aryanthomare/SmartKnob/docs/images/haptic_profile_dark.png

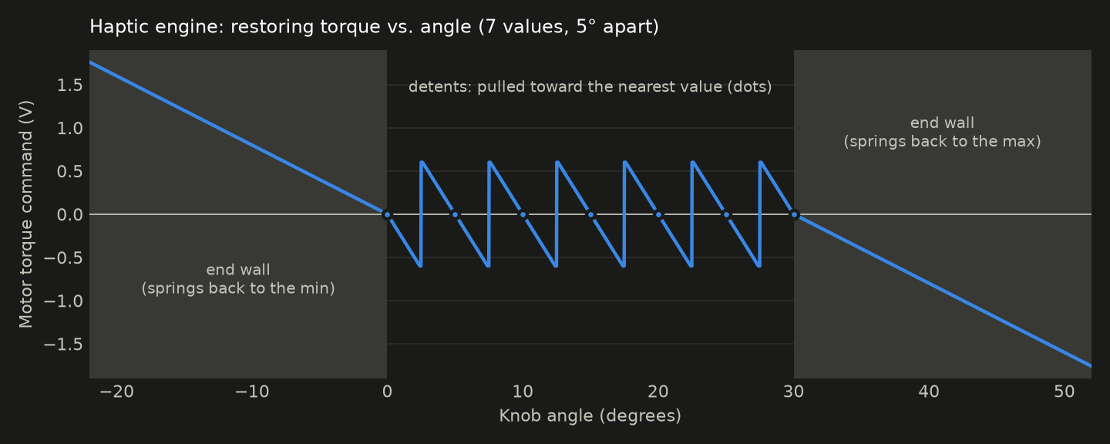
docs/images/haptic_profile_dark.png
