aryanthomare/SmartKnob/docs/images/panel_scroll_dark.png

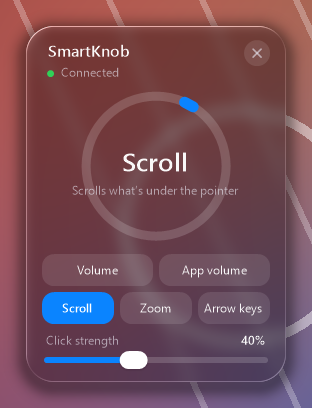
docs/images/panel_scroll_dark.png
