aryanthomare/SmartKnob/docs/images/panel_volume_light.png

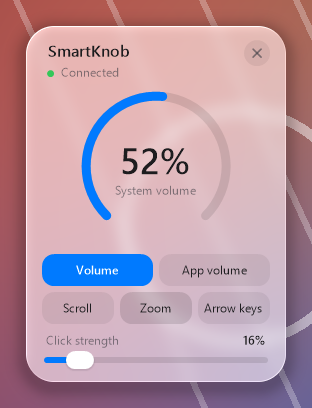
docs/images/panel_volume_light.png
