aryanthomare/SmartKnob/docs/images/schematic_overview.png

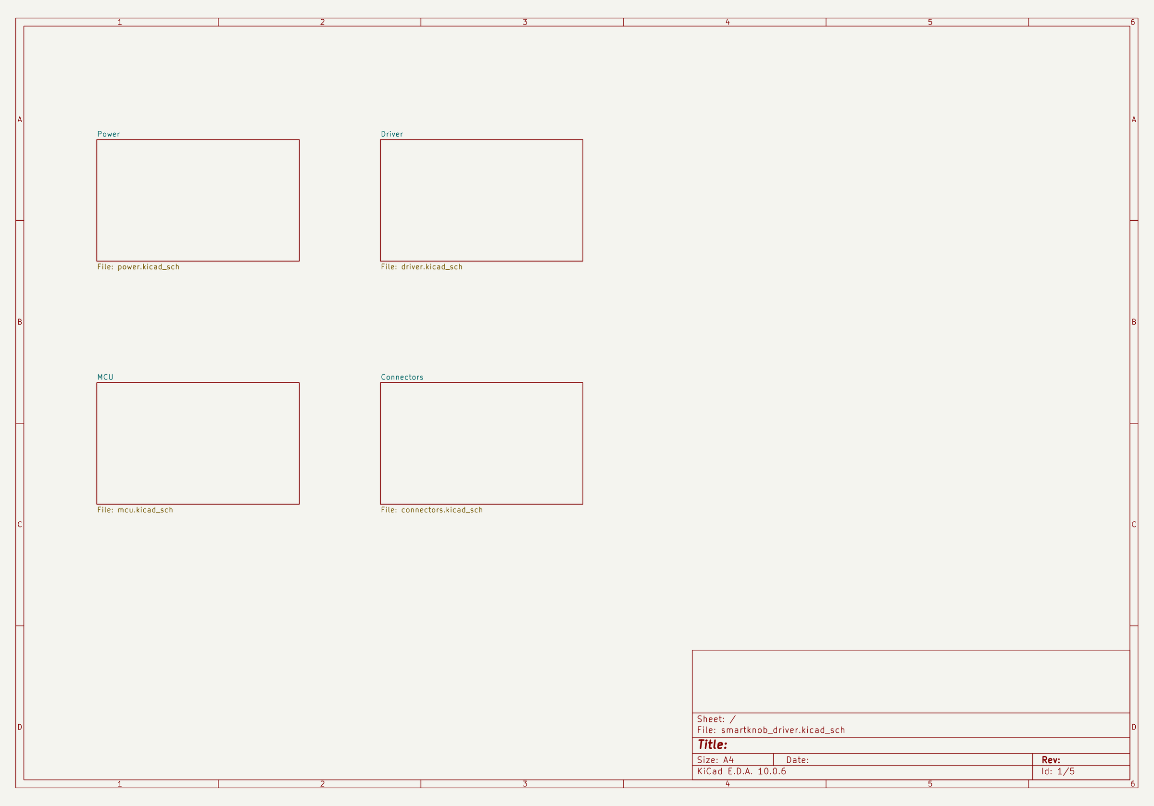
docs/images/schematic_overview.png
