aryanthomare/SmartKnob/hardware/smartknob_driver/smartknob_driver_placement_2d.png

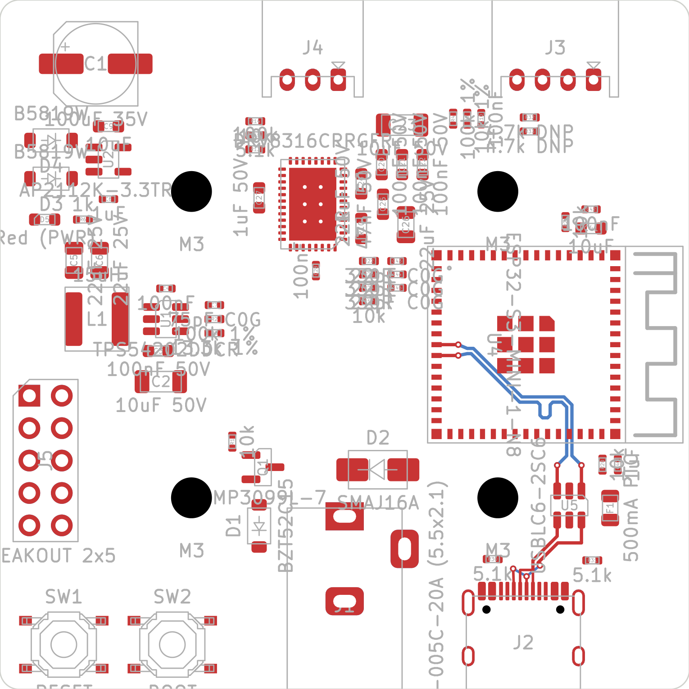
hardware/smartknob_driver/smartknob_driver_placement_2d.png
