aryanthomare/SmartKnob/hardware/smartknob_driver/smartknob_driver_placement_3d.png

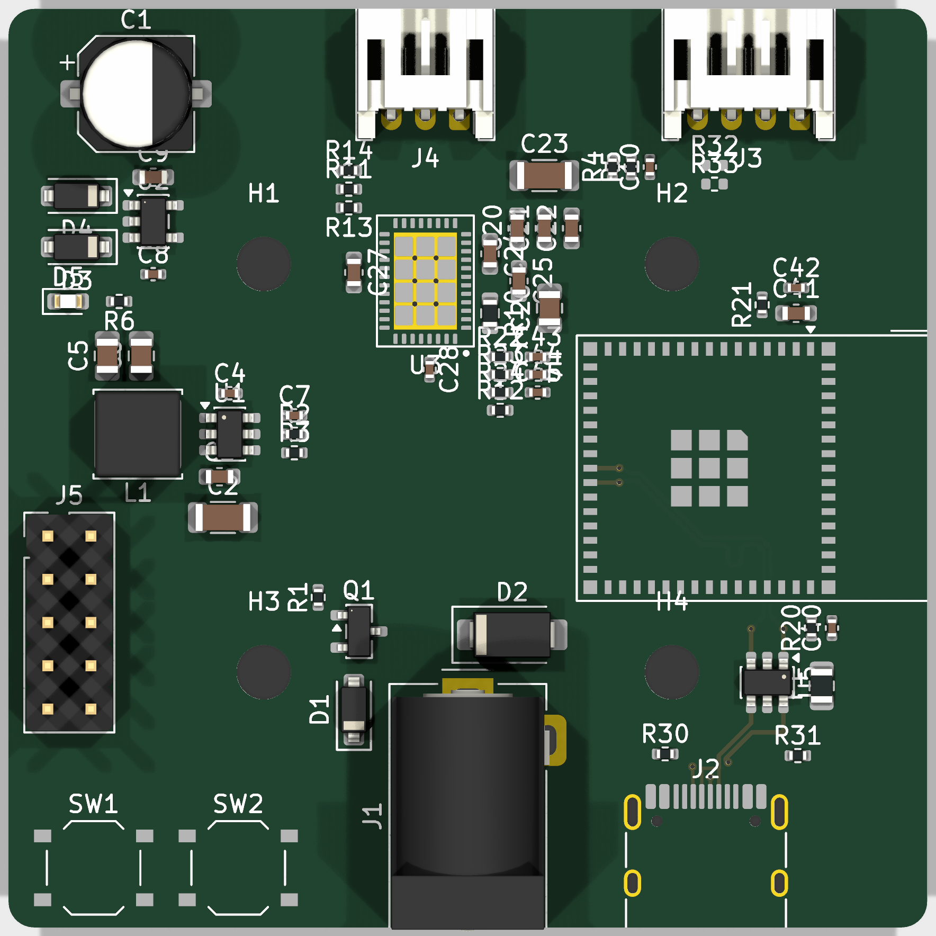
hardware/smartknob_driver/smartknob_driver_placement_3d.png
