aryanthomare/SmartKnob/hardware/smartknob_driver/smartknob_driver_top_render.png

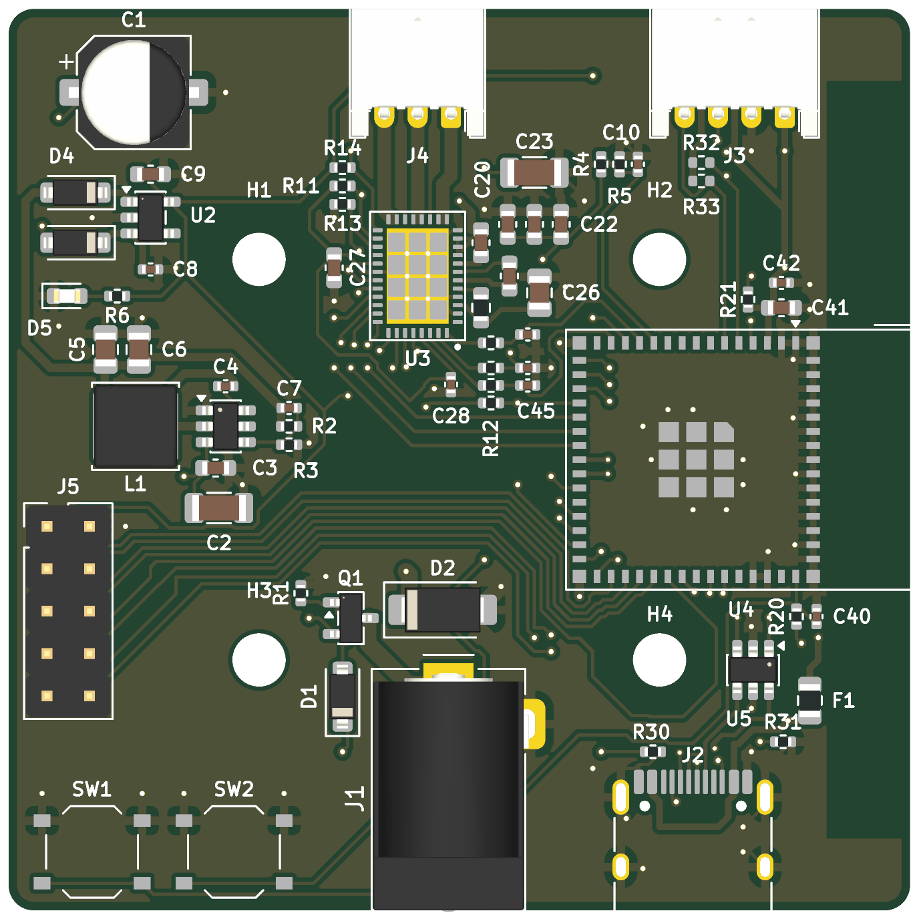
hardware/smartknob_driver/smartknob_driver_top_render.png
