aryanthomare/SmartKnob/hardware/smartknob_driver/fab/smartknob_driver_BOM_JLC.csv

Comment | Designator | Footprint | LCSC Part # | Quantity
100uF 35V | C1 | Capacitor_SMD:CP_Elec_6.3x7.7 | C294520 | 1
10uF 50V | C2,C23 | Capacitor_SMD:C_1206_3216Metric | C13585 | 2
100nF 50V | C3,C20,C21,C22 | Capacitor_SMD:C_0603_1608Metric | C14663 | 4
100nF | C4,C10,C28,C42 | Capacitor_SMD:C_0402_1005Metric | C1525 | 4
22uF 25V | C5,C6,C26 | Capacitor_SMD:C_0805_2012Metric | C45783 | 3
75pF C0G | C7 | Capacitor_SMD:C_0402_1005Metric | C107010 | 1
1uF | C8,C40 | Capacitor_SMD:C_0402_1005Metric | C52923 | 2
10uF | C9,C41 | Capacitor_SMD:C_0603_1608Metric | C19702 | 2
1uF 50V | C24,C27 | Capacitor_SMD:C_0603_1608Metric | C15849 | 2
47nF 50V | C25 | Capacitor_SMD:C_0603_1608Metric | C1622 | 1
22pF C0G | C43,C44,C45 | Capacitor_SMD:C_0402_1005Metric | C1555 | 3
BZT52C15 | D1 | Diode_SMD:D_SOD-123 | C2932746 | 1
SMAJ16A | D2 | Diode_SMD:D_SMA | C74561 | 1
B5819W | D3,D4 | Diode_SMD:D_SOD-123 | C8598 | 2
Red (PWR) | D5 | LED_SMD:LED_0603_1608Metric | C2286 | 1
500mA PTC | F1 | Fuse:Fuse_0805_2012Metric | C20978 | 1
DC-005C-20A (5.5x2.1) | J1 | smartknob:BarrelJack_Hroparts_DC-005C-20A_Horizontal | C84007 | 1
TYPE-C-31-M-12 | J2 | Connector_USB:USB_C_Receptacle_HRO_TYPE-C-31-M-12 | C165948 | 1
ENCODER (S4B-PH-K-S) | J3 | Connector_JST:JST_PH_S4B-PH-K_1x04_P2.00mm_Horizontal | C157926 | 1
MOTOR (S3B-PH-K-S) | J4 | Connector_JST:JST_PH_S3B-PH-K_1x03_P2.00mm_Horizontal | C157929 | 1
BREAKOUT 2x5 | J5 | Connector_PinHeader_2.54mm:PinHeader_2x05_P2.54mm_Vertical |  | 1
15uH | L1 | Inductor_SMD:L_Sunlord_SWPA5040S | C44888 | 1
DMP3099L-7 | Q1 | Package_TO_SOT_SMD:SOT-23 | C155244 | 1
10k 1% | R1,R5,R12,R14,R20,R21 | Resistor_SMD:R_0402_1005Metric | C25744 | 6
100k 1% | R2,R4,R13 | Resistor_SMD:R_0402_1005Metric | C25741 | 3
13.3k 1% | R3 | Resistor_SMD:R_0402_1005Metric | C274352 | 1
1k | R6 | Resistor_SMD:R_0402_1005Metric | C11702 | 1
22R | R10 | Resistor_SMD:R_0603_1608Metric | C23345 | 1
5.1k | R11,R30,R31 | Resistor_SMD:R_0402_1005Metric | C25905 | 3
330R | R22,R23,R24 | Resistor_SMD:R_0402_1005Metric | C25104 | 3
TS-1187A pushbutton | SW1,SW2 | Button_Switch_SMD:SW_Push_1P1T_XKB_TS-1187A | C318884 | 2
TPS54202DDCR | U1 | Package_TO_SOT_SMD:SOT-23-6 | C191884 | 1
AP2112K-3.3TRG1 | U2 | Package_TO_SOT_SMD:SOT-23-5 | C51118 | 1
DRV8316CRRGFR | U3 | smartknob:TI_RGF0040E_VQFN-40-1EP_5x7mm_P0.5mm_EP3.7x5.7mm_ThermalVias | C5447274 | 1
ESP32-S3-MINI-1-N8 | U4 | RF_Module:ESP32-S2-MINI-1 | C2913206 | 1
USBLC6-2SC6 | U5 | Package_TO_SOT_SMD:SOT-23-6 | C7519 | 1
