aryanthomare/SmartKnob/enclosure/smartknob_driver.step

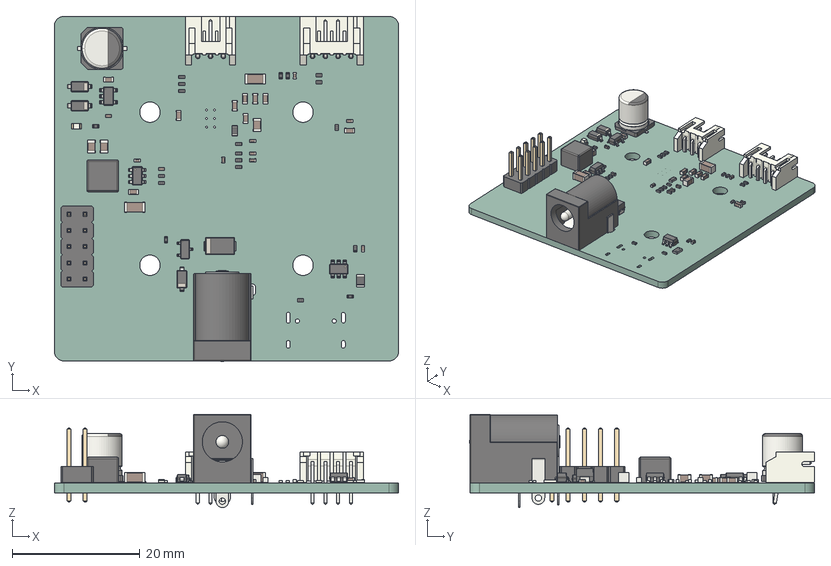
[picture p21: CAD file, 2026-10-10]
enclosure/smartknob_driver.step
54.0 x 54.1 x 14.6 mm
C_0402_1005Metric x 10
R_0402_1005Metric x 19
PinHeader_2x05_P254mm_Vertical
C_0603_1608Metric x 9
JST_S4B_PH_K
D_SOD-123 x 3
C_1206_3216Metric x 2
Fuse_0805_2012Metric
SOT-23-6 x 2
BarrelJack_Horizontal
SOT-23
JST_S3B_PH_K
C_0805_2012Metric x 3
LED_0603_1608Metric
SOT-23-5
R_0603_1608Metric
a69dfe88-8551-11ed-a139-00155d22e2d7_part
a69dffdc-8551-11ed-a139-00155d22e2d7_part
a69e005e-8551-11ed-a139-00155d22e2d7_part
CP_Elec_63x77
D_SMA
smartknob_driver_PCB
