aryanthomare/SmartKnob/hardware/smartknob_driver/smartknob_driver_schematic.pdf

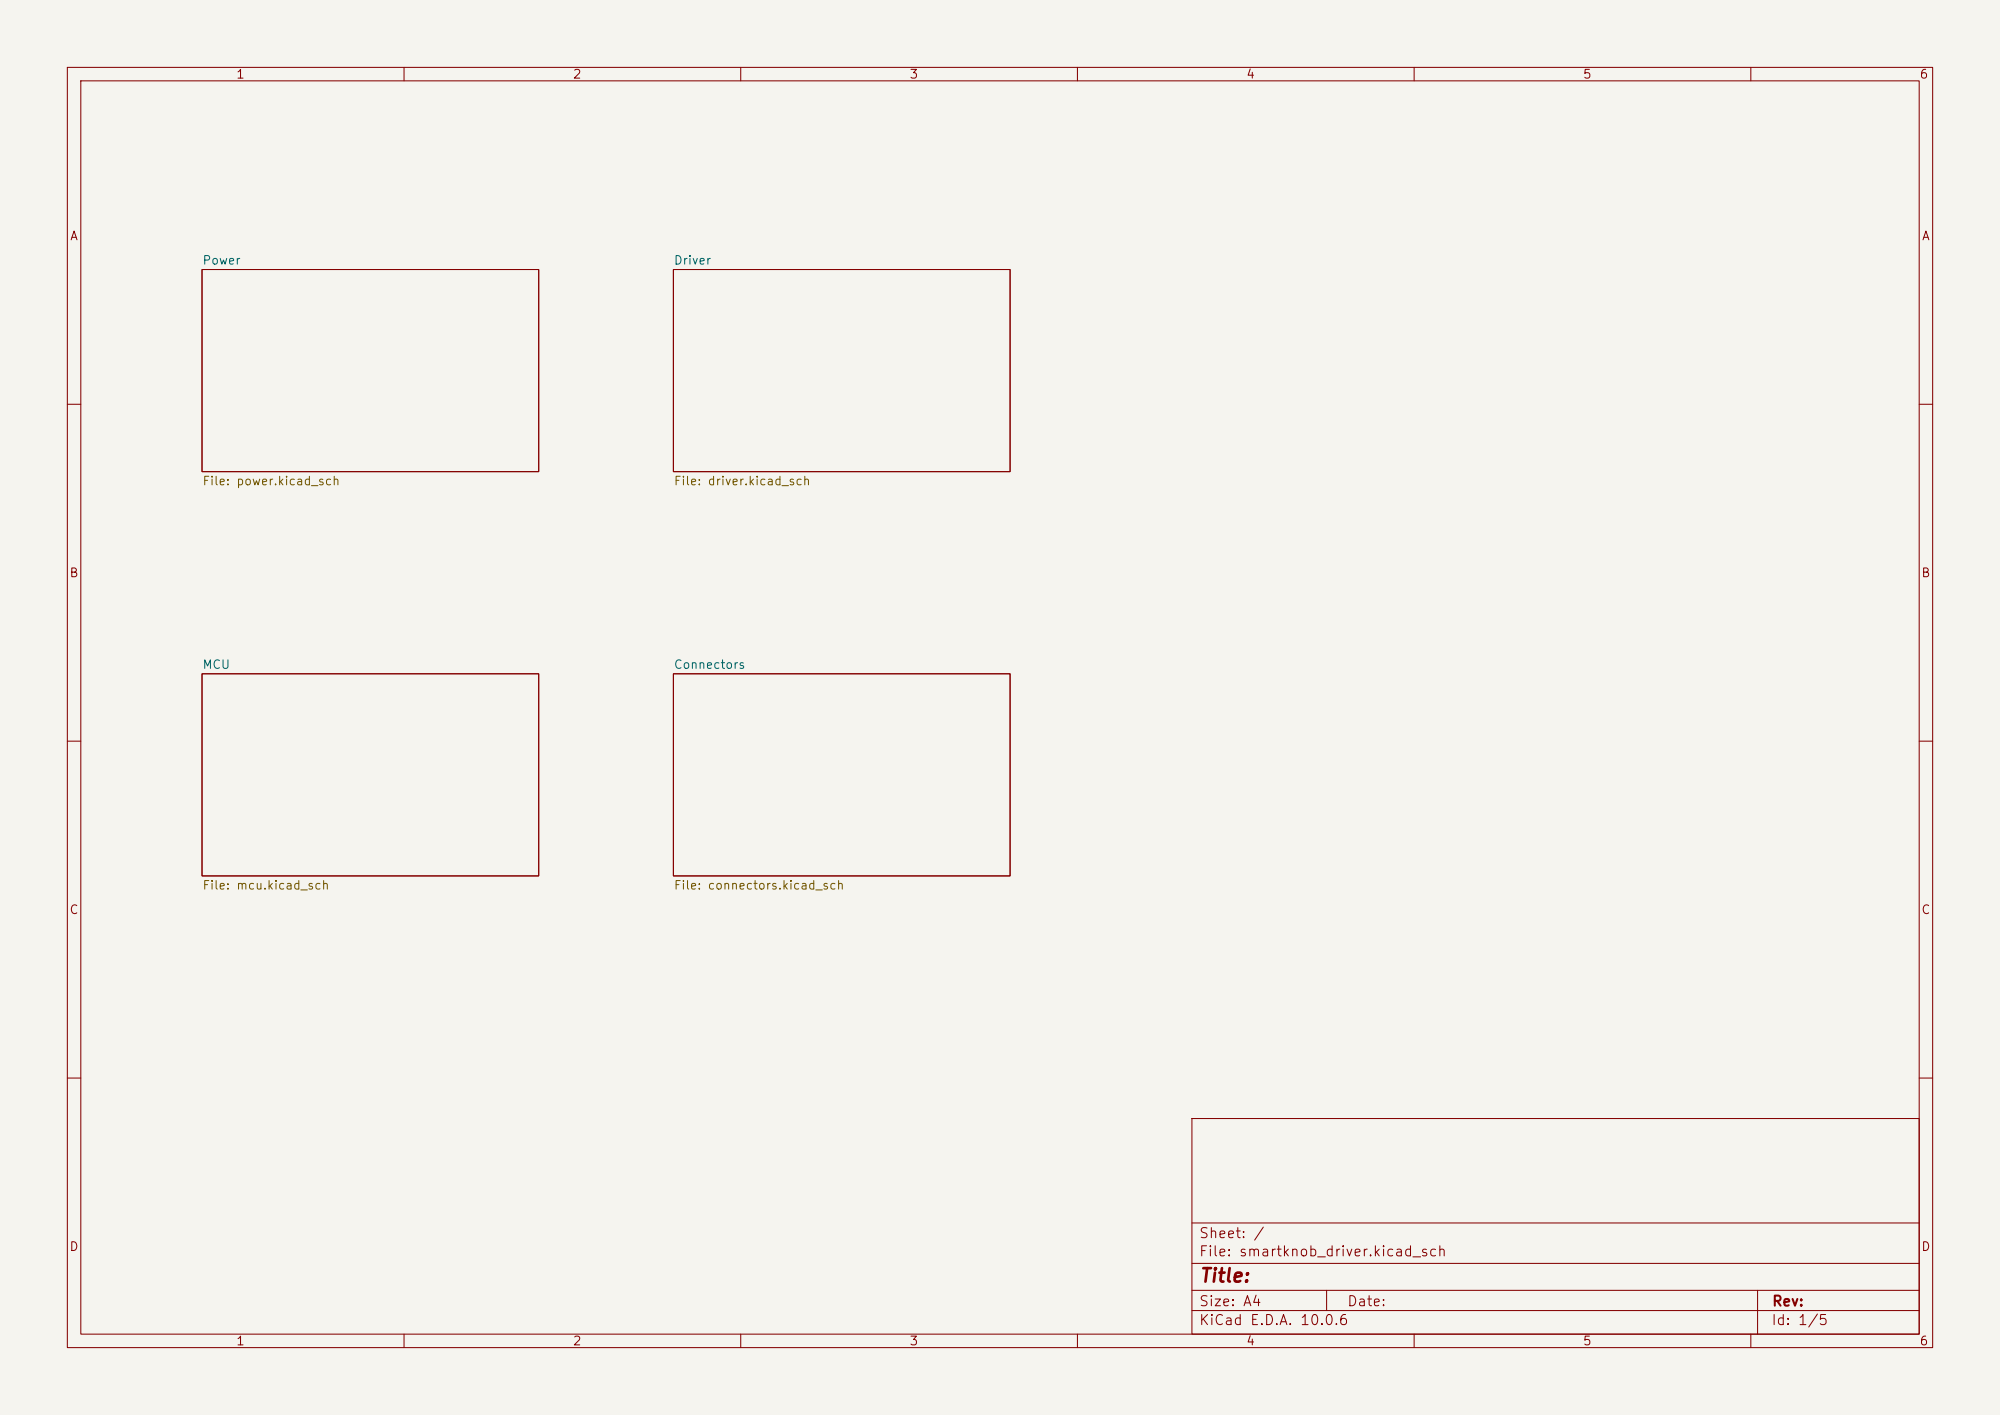
[picture p22: page 1]

Size: A4 | Rev:
KiCad E.D.A. 10.0.6 | Id: 1/5

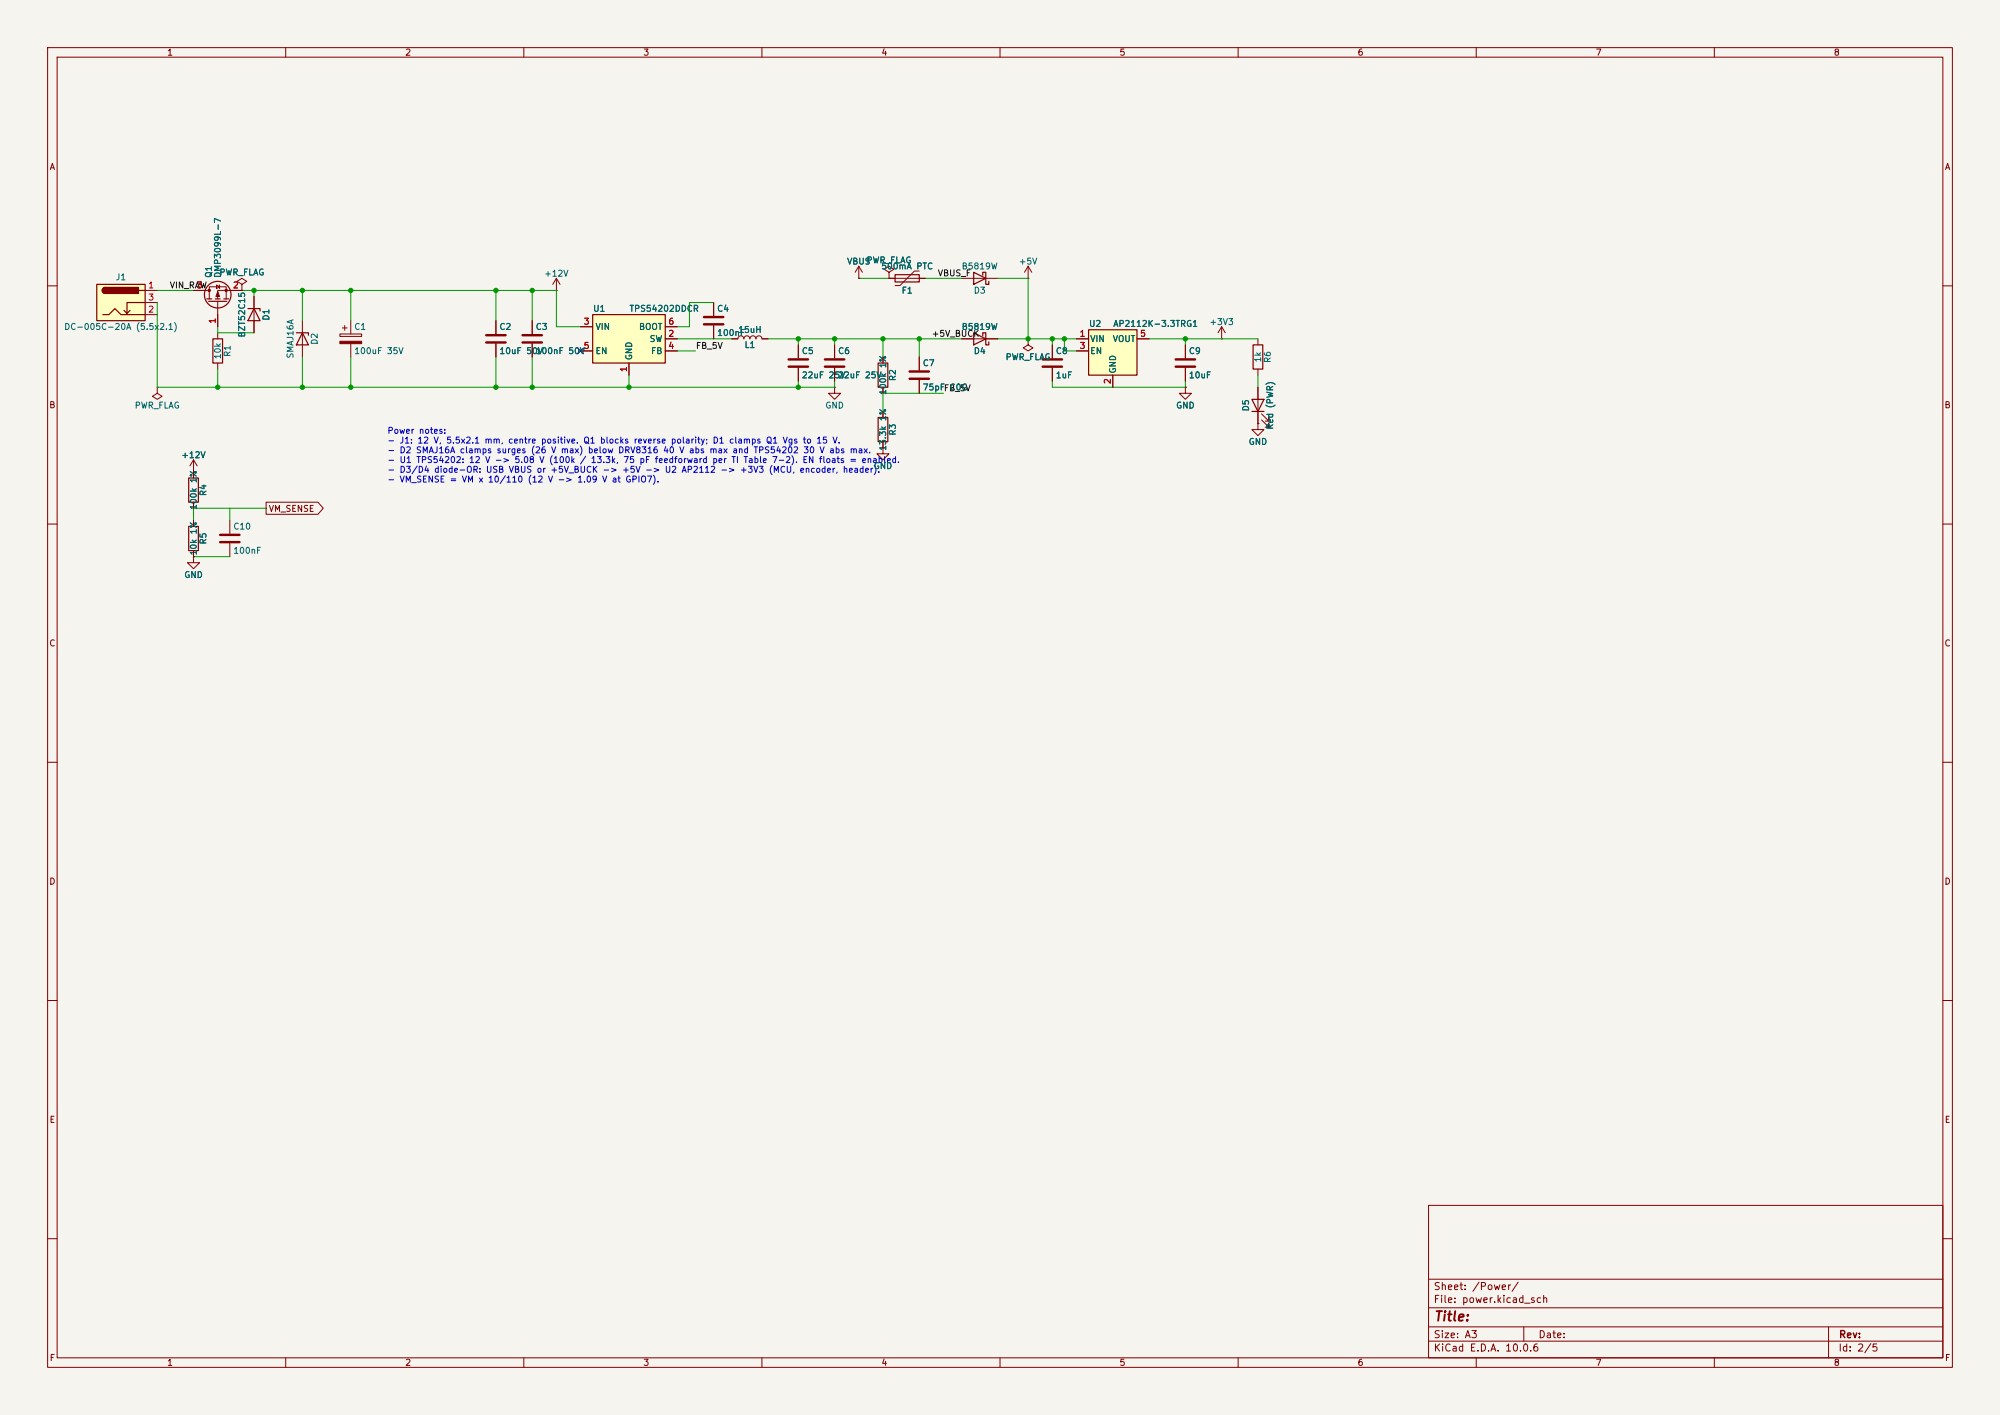
[picture p23: page 2]

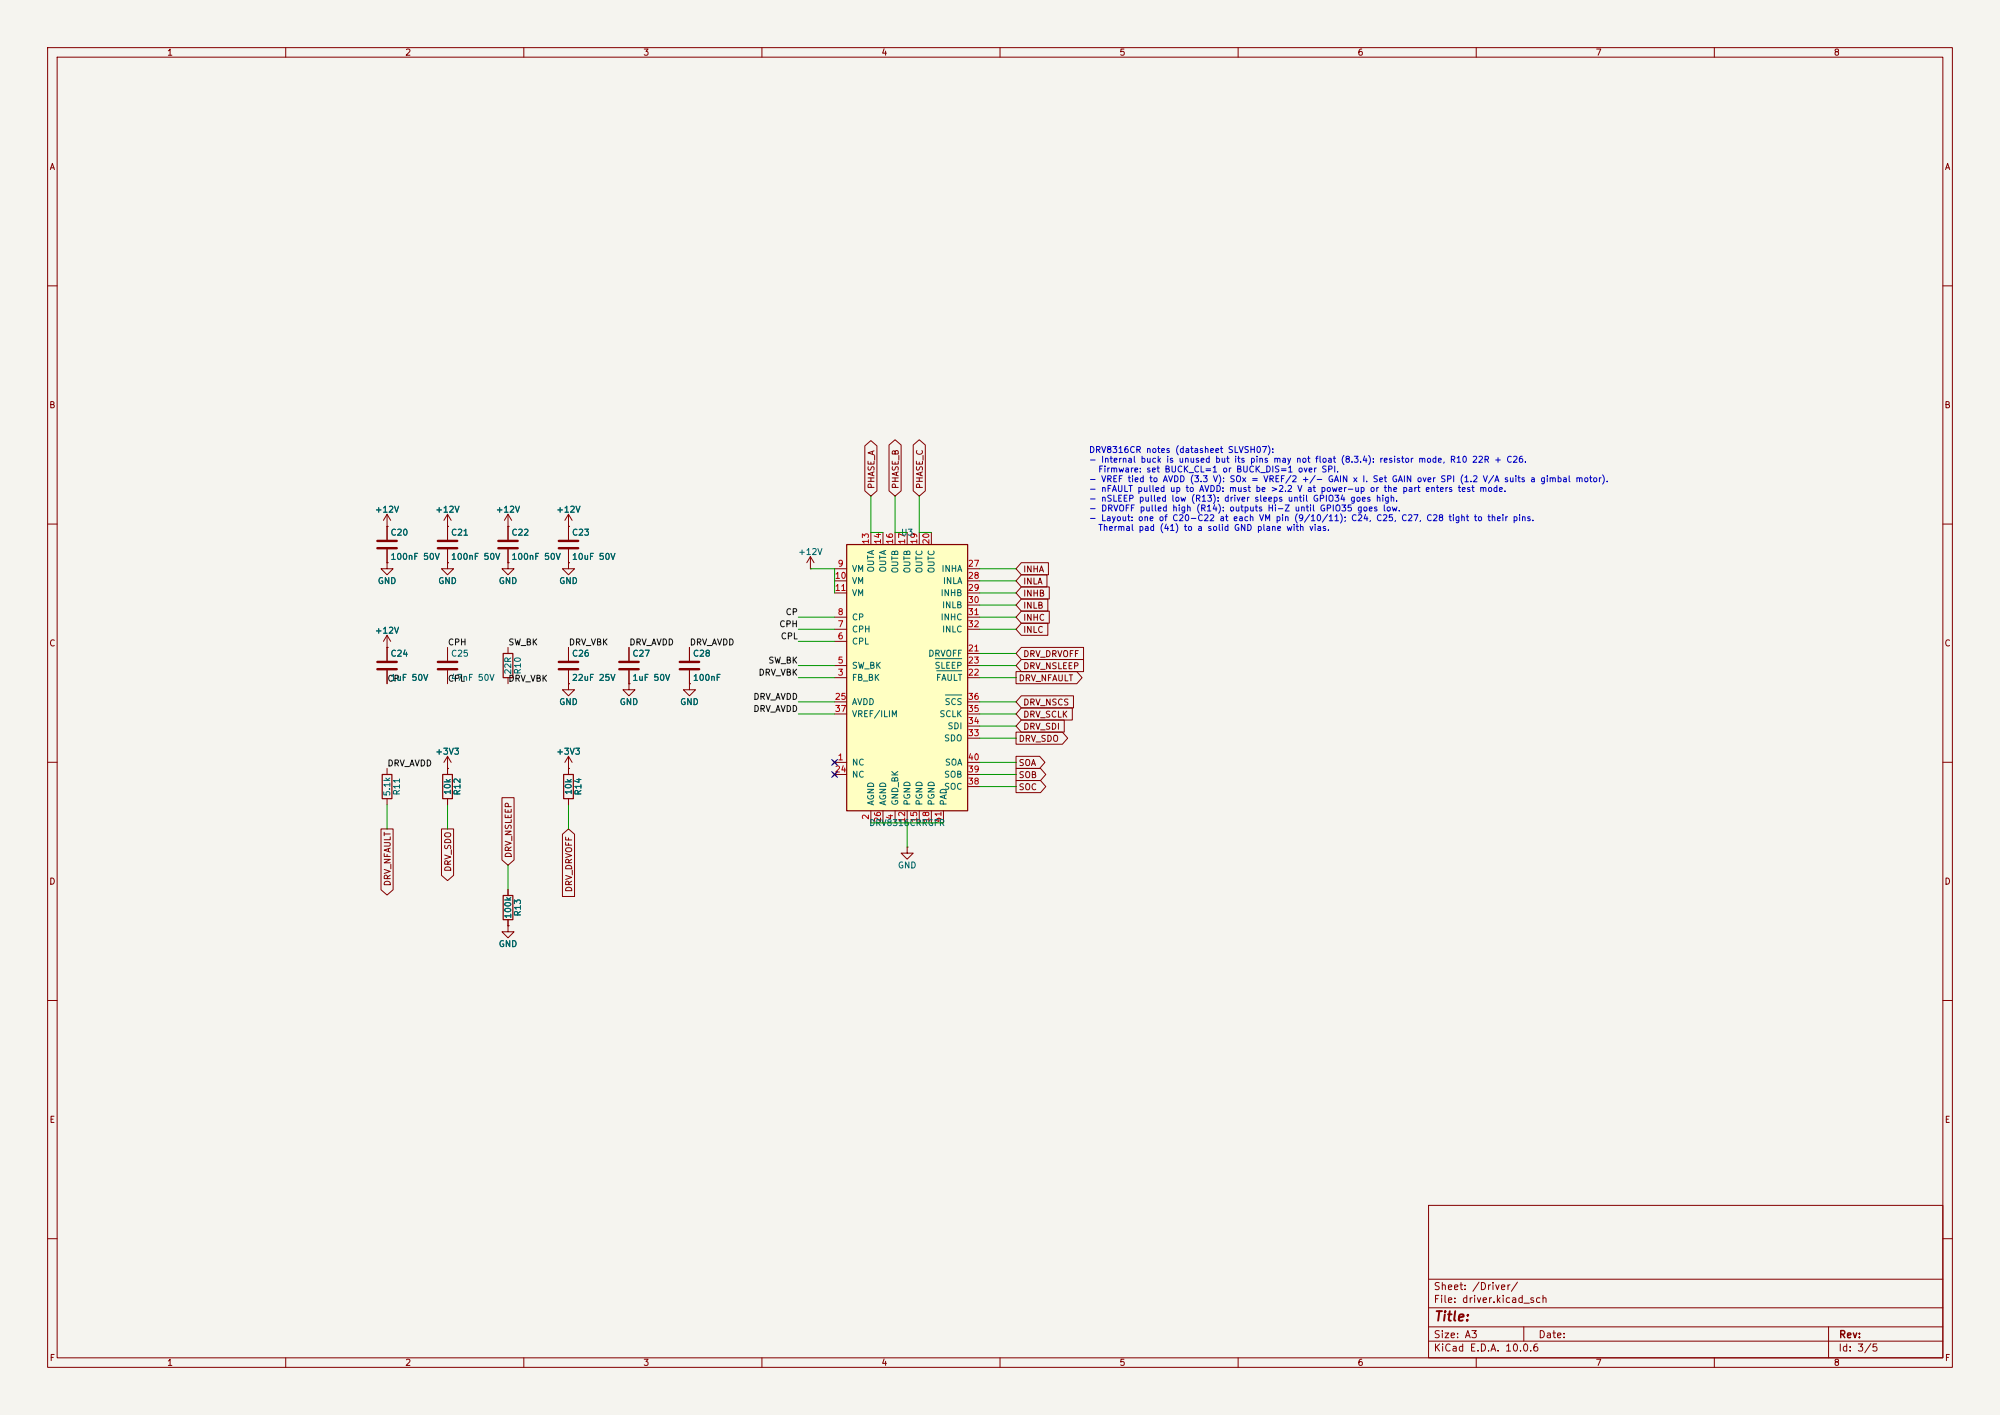
[picture p24: page 3]

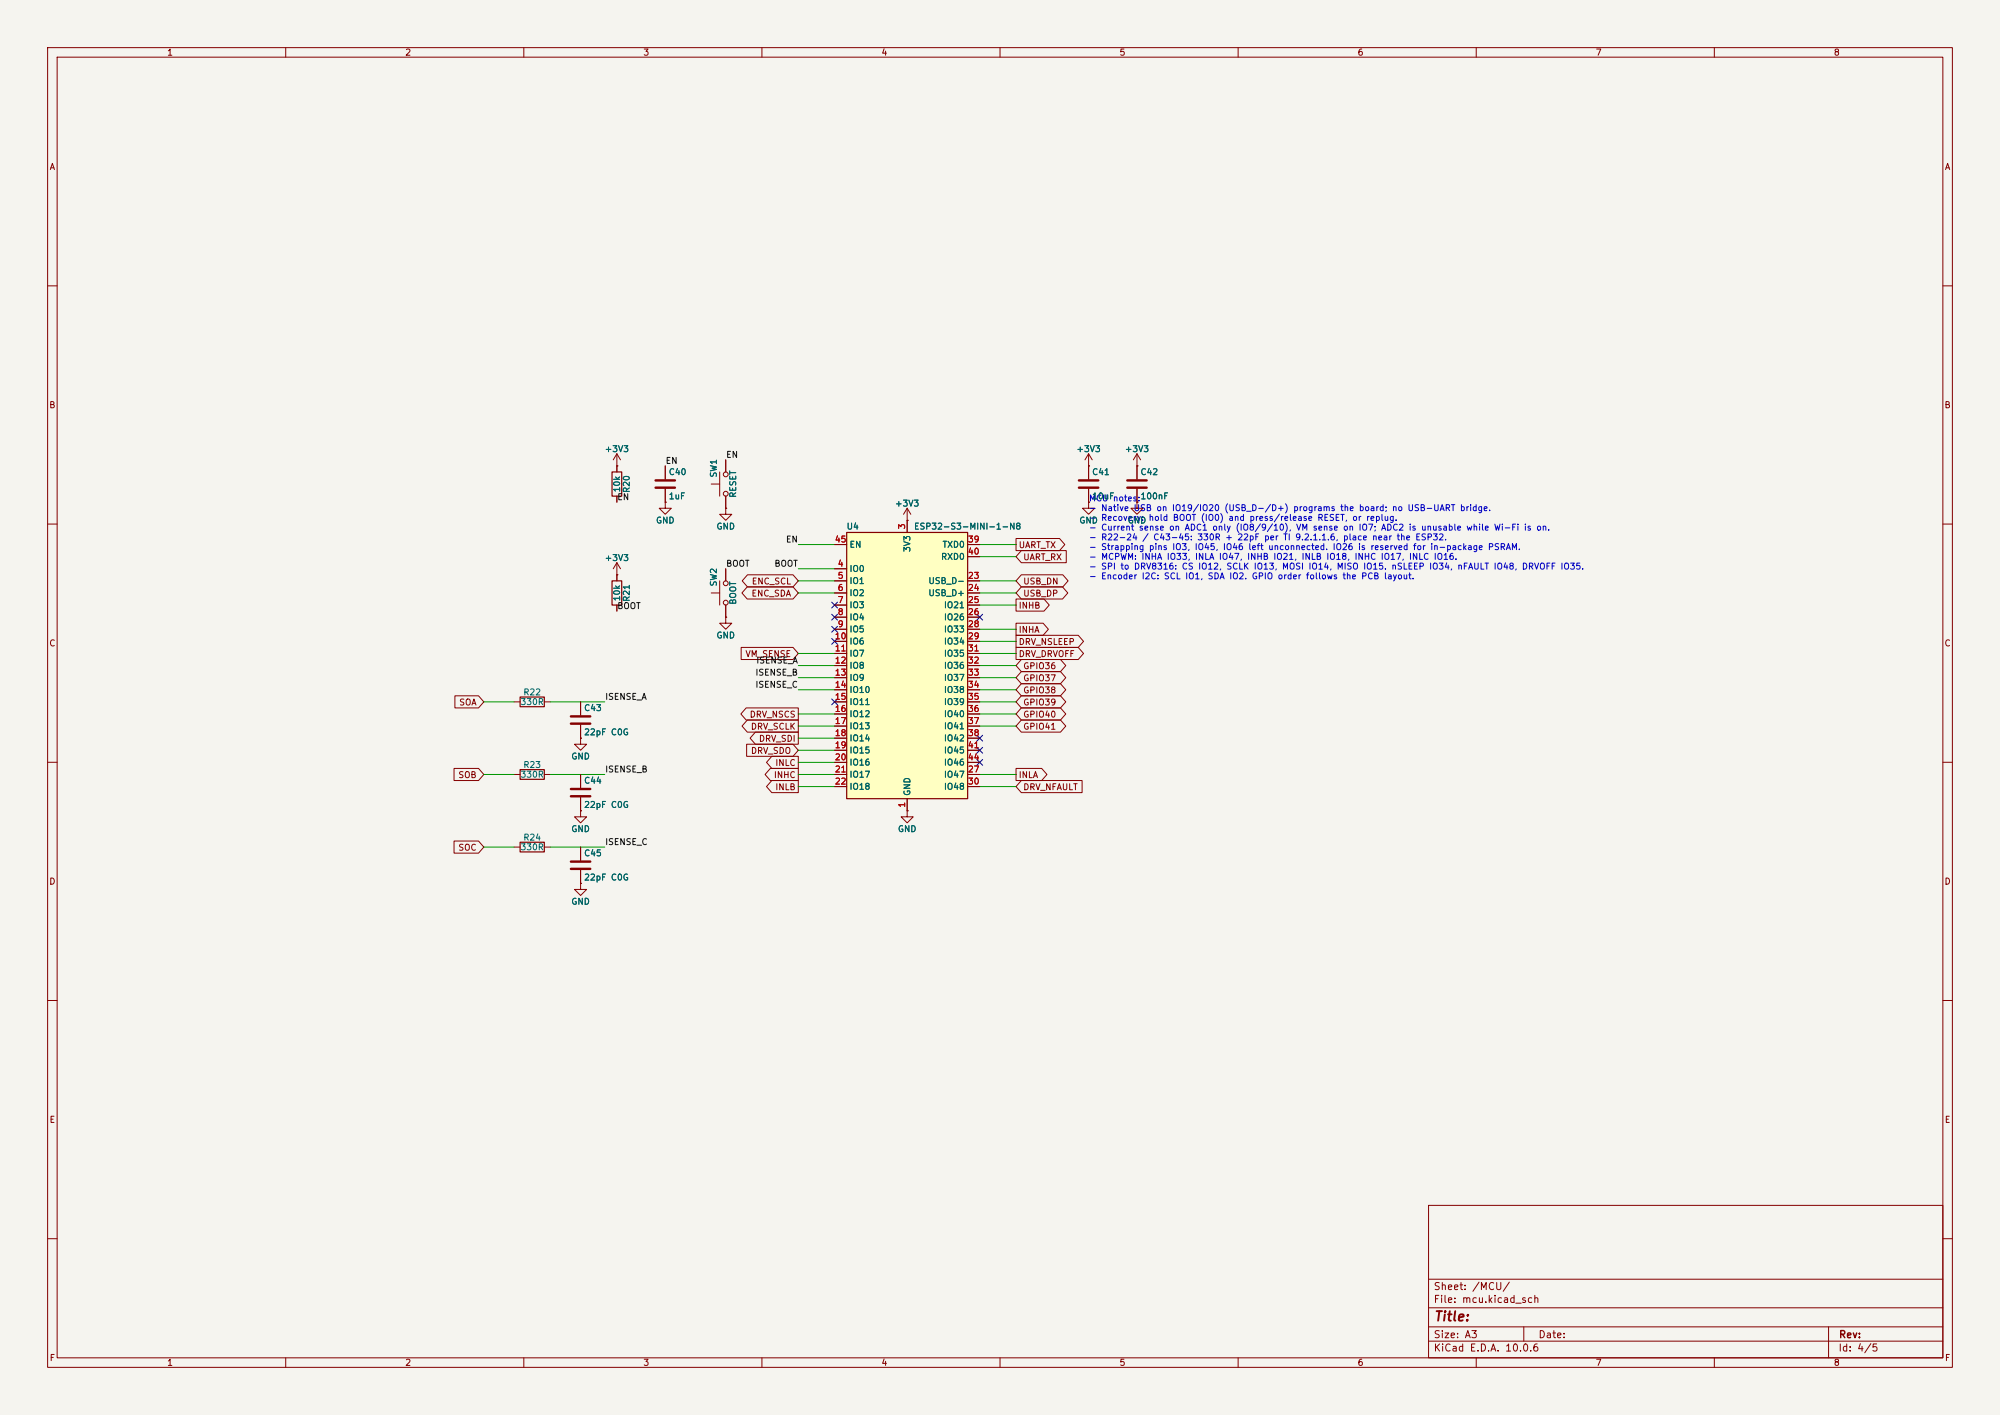
[picture p25: page 4]

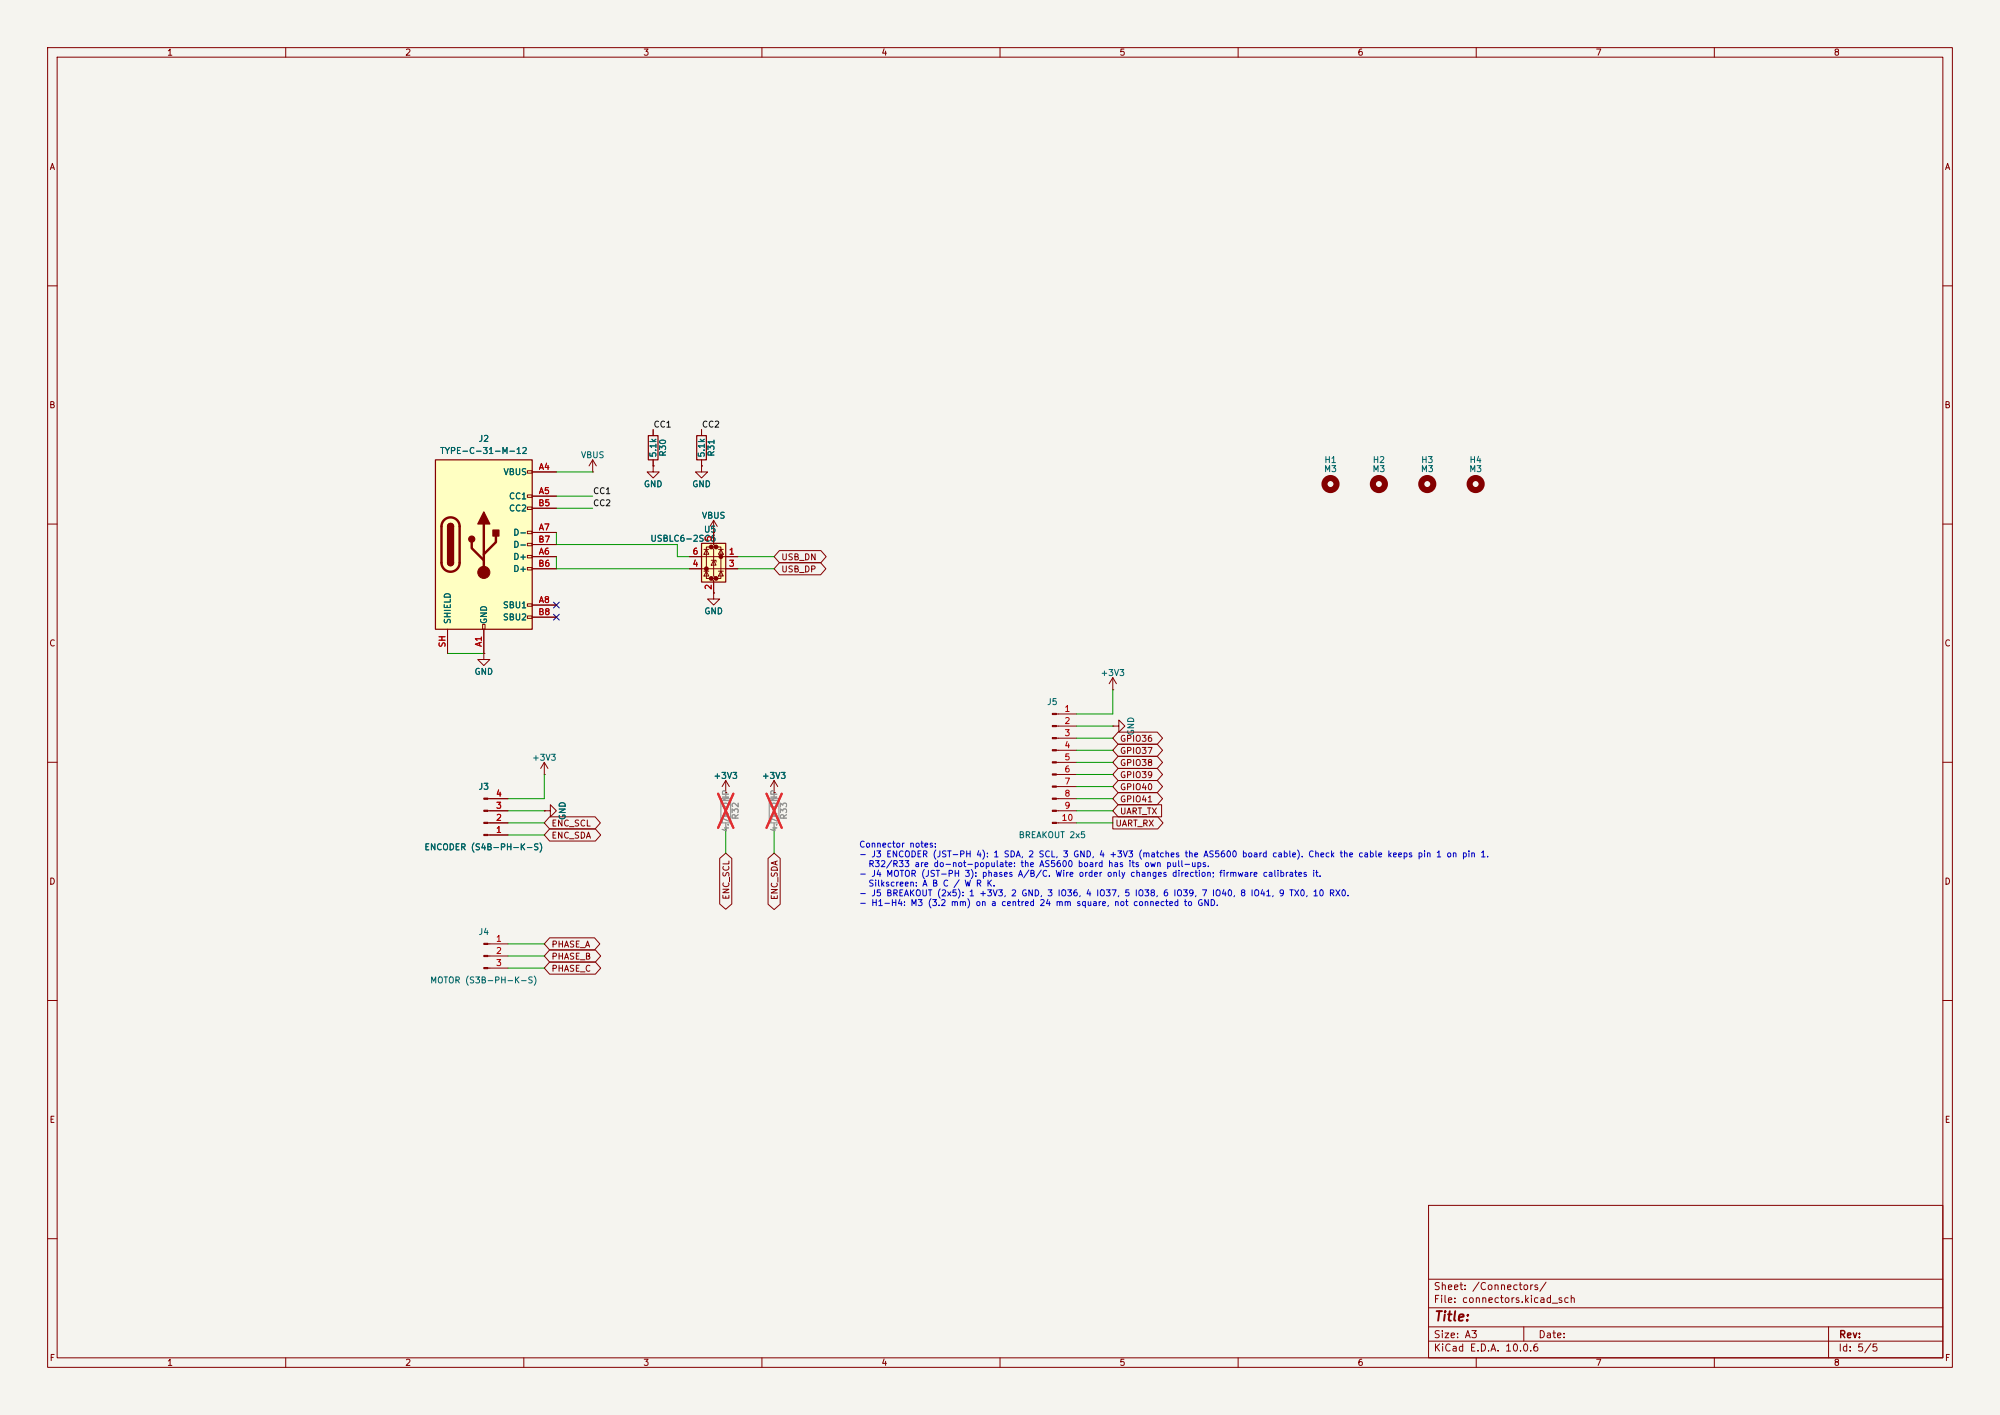
[picture p26: page 5]
