aryanthomare/SmartKnob/hardware/smartknob_driver/smartknob_driver.kicad_pcb

## KiCad design hardware/smartknob_driver/smartknob_driver.kicad_pcb (2026-10-10)

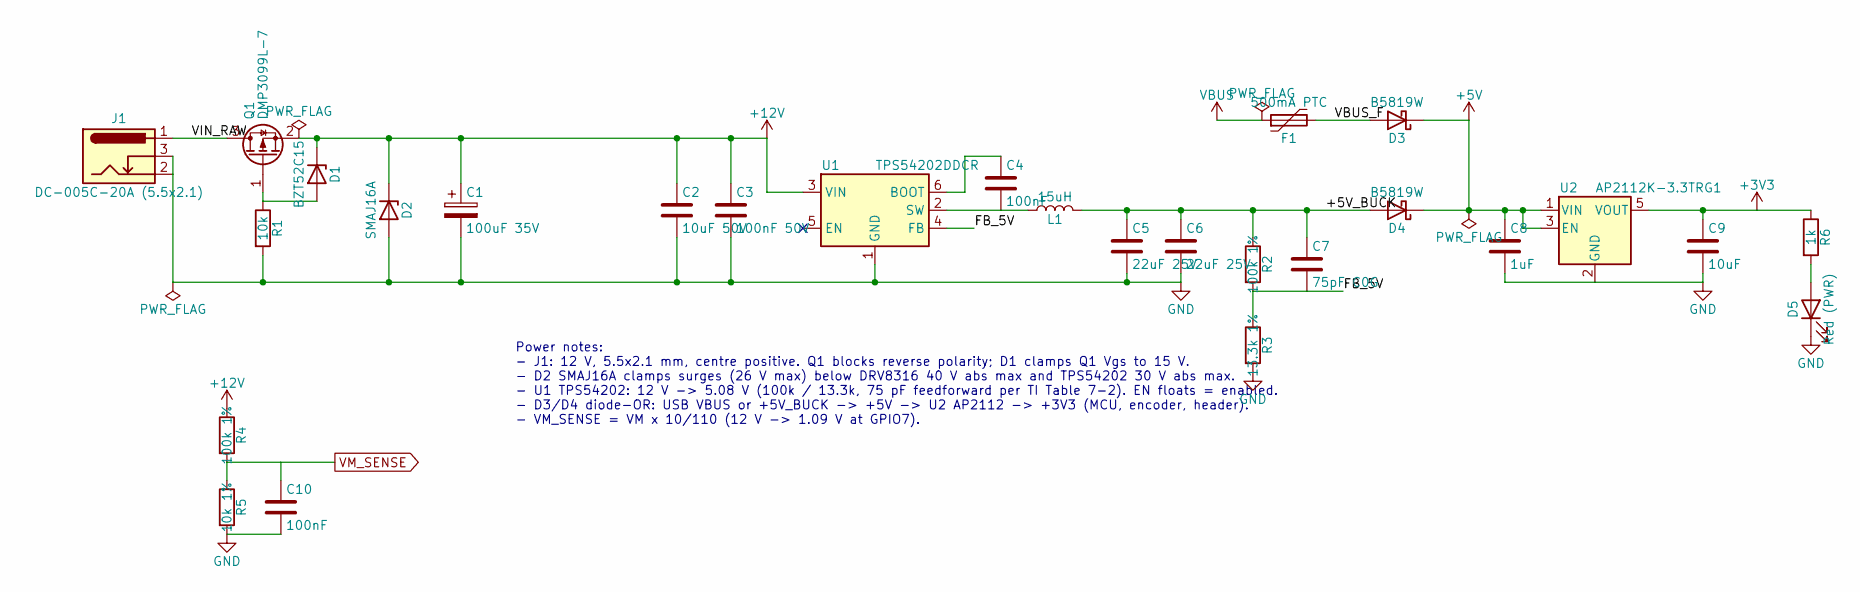
[picture p27: schematic power.kicad_sch]

Parts:
C1: 100uF 35V; CP_Elec_6.3x7.7; LCSC C294520
C2: 10uF 50V; C_1206_3216Metric; LCSC C13585
C3: 100nF 50V; C_0603_1608Metric; LCSC C14663
C4, C10: 100nF; C_0402_1005Metric; LCSC C1525
C5, C6: 22uF 25V; C_0805_2012Metric; LCSC C45783
C7: 75pF C0G; C_0402_1005Metric; LCSC C107010
C8: 1uF; C_0402_1005Metric; LCSC C52923
C9: 10uF; C_0603_1608Metric; LCSC C19702
D1: BZT52C15; D_SOD-123; LCSC C2932746
D2: SMAJ16A; D_SMA; LCSC C74561
D3, D4: B5819W; D_SOD-123; LCSC C8598
D5: Red (PWR); LED_0603_1608Metric; LCSC C2286
F1: 500mA PTC; Fuse_0805_2012Metric; LCSC C20978
J1: DC-005C-20A (5.5x2.1); BarrelJack_Hroparts_DC-005C-20A_Horizontal; LCSC C84007
L1: 15uH; L_Sunlord_SWPA5040S; LCSC C44888
Q1: DMP3099L-7; SOT-23; LCSC C155244
R1: 10k; R_0402_1005Metric; LCSC C25744
R2, R4: 100k 1%; R_0402_1005Metric; LCSC C25741
R3: 13.3k 1%; R_0402_1005Metric; LCSC C274352
R5: 10k 1%; R_0402_1005Metric; LCSC C25744
R6: 1k; R_0402_1005Metric; LCSC C11702
U1: TPS54202DDCR; SOT-23-6; LCSC C191884
U2: AP2112K-3.3TRG1; SOT-23-5; LCSC C51118

Connections:
+3V3: C9.1, R6.1, U2.5 (VOUT); also elsewhere on the board
+5V: C8.1, D3.1 (K), D4.1 (K), U2.1 (VIN), U2.3 (EN)
+12V: C1.1, C2.1, C3.1, D1.1 (K), D2.1 (K), Q1.2 (S), R4.1, U1.3 (VIN); also elsewhere on the board
/Power/+5V_BUCK: C5.1, C6.1, C7.1, D4.2 (A), L1.2, R2.1
/Power/FB_5V: C7.2, R2.2, R3.1, U1.4 (FB)
/Power/VBUS_F: D3.2 (A), F1.2
/Power/VIN_RAW: J1.1, Q1.3 (D)
GND: C1.2, C2.2, C3.2, C5.2, C6.2, C8.2, C9.2, C10.2, D2.2 (A), D5.1 (K), J1.2, J1.3, R1.2, R3.2, R5.2, U1.1 (GND), U2.2 (GND); also elsewhere on the board
unnamed: D1.2 (A), Q1.1 (G), R1.1
unnamed: D5.2 (A), R6.2
unnamed: C4.1, U1.6 (BOOT)
unnamed: C4.2, L1.1, U1.2 (SW)
VBUS: F1.1; also elsewhere on the board
VM_SENSE: C10.1, R4.2, R5.1; also elsewhere on the board

Notes on the sheet:
Power notes: - J1: 12 V, 5.5x2.1 mm, centre positive. Q1 blocks reverse polarity; D1 clamps Q1 Vgs to 15 V. - D2 SMAJ16A clamps surges (26 V max) below DRV8316 40 V abs max and TPS54202 30 V abs max. - U1 TPS54202: 12 V -> 5.08 V (100k / 13.3k, 75 pF feedforward per TI Table 7-2). EN floats = enabl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

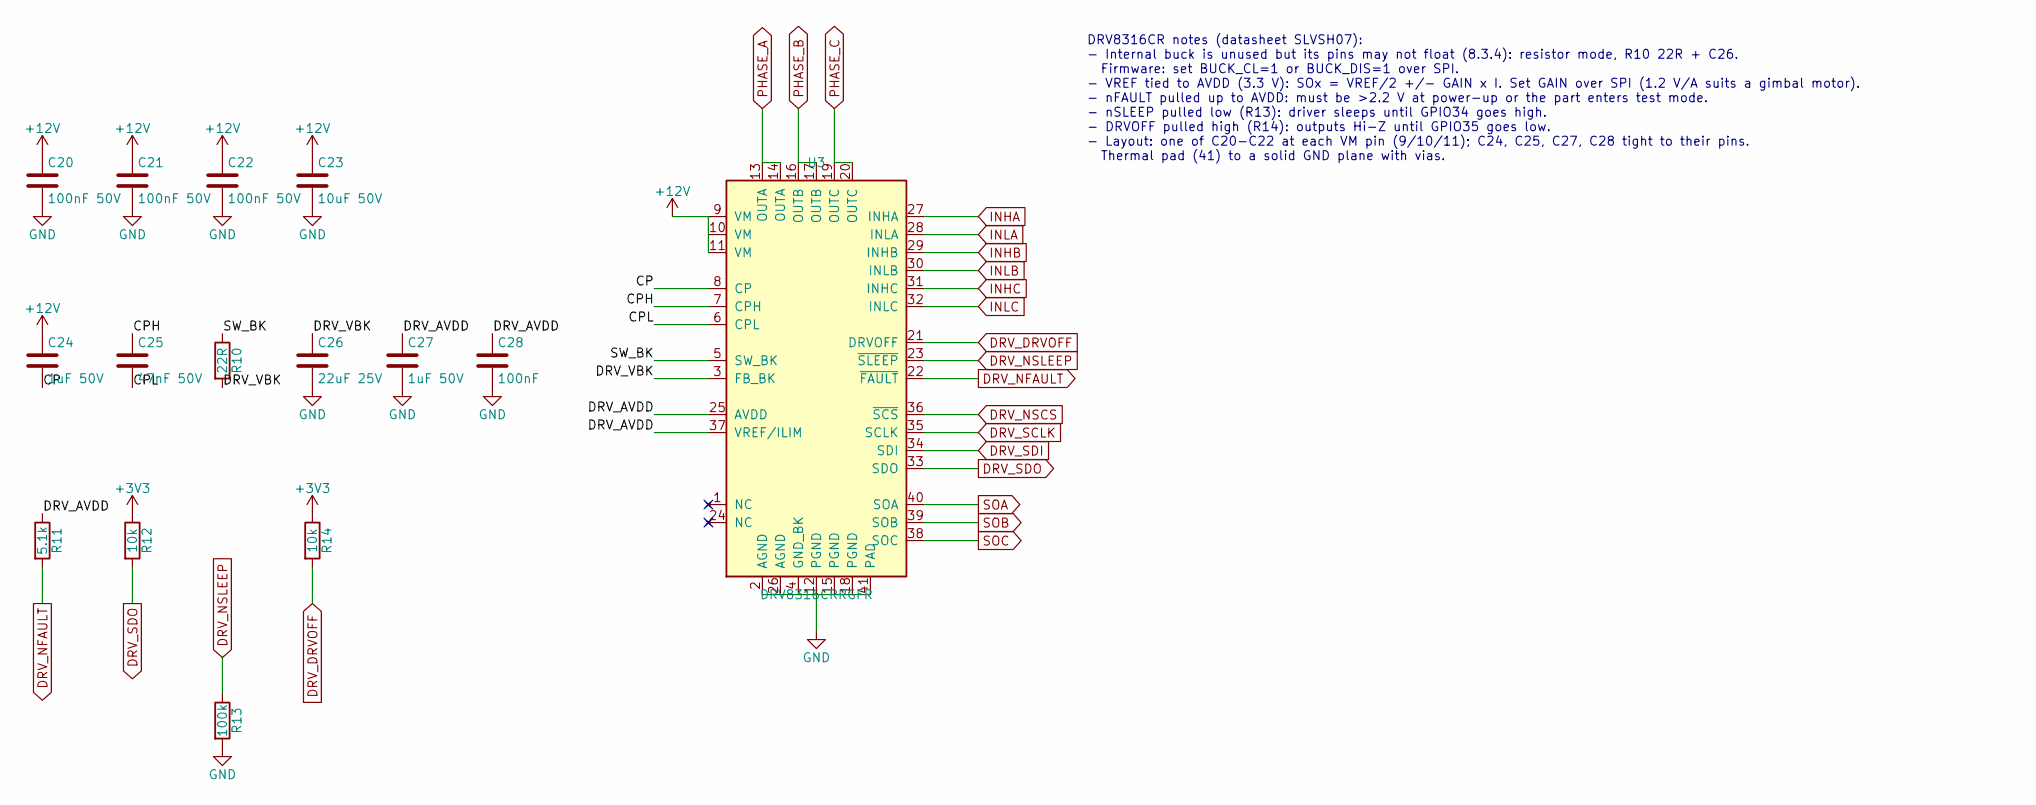
[picture p28: schematic driver.kicad_sch]

Parts:
C20, C21, C22: 100nF 50V; C_0603_1608Metric; LCSC C14663
C23: 10uF 50V; C_1206_3216Metric; LCSC C13585
C24, C27: 1uF 50V; C_0603_1608Metric; LCSC C15849
C25: 47nF 50V; C_0603_1608Metric; LCSC C1622
C26: 22uF 25V; C_0805_2012Metric; LCSC C45783
C28: 100nF; C_0402_1005Metric; LCSC C1525
R10: 22R; R_0603_1608Metric; LCSC C23345
R11: 5.1k; R_0402_1005Metric; LCSC C25905
R12, R14: 10k; R_0402_1005Metric; LCSC C25744
R13: 100k; R_0402_1005Metric; LCSC C25741
U3: DRV8316CRRGFR; TI_RGF0040E_VQFN-40-1EP_5x7mm_P0.5mm_EP3.7x5.7mm_ThermalVias; LCSC C5447274

Connections:
+3V3: R12.1, R14.1; also elsewhere on the board
+12V: C20.1, C21.1, C22.1, C23.1, C24.1, U3.9 (VM), U3.10 (VM), U3.11 (VM); also elsewhere on the board
/Driver/CP: C24.2, U3.8 (CP)
/Driver/CPH: C25.1, U3.7 (CPH)
/Driver/CPL: C25.2, U3.6 (CPL)
/Driver/DRV_AVDD: C27.1, C28.1, R11.1, U3.25 (AVDD), U3.37 (VREF/ILIM)
/Driver/DRV_VBK: C26.1, R10.2, U3.3 (FB_BK)
/Driver/SW_BK: R10.1, U3.5 (SW_BK)
DRV_DRVOFF: R14.2, U3.21 (DRVOFF); also elsewhere on the board
DRV_NFAULT: R11.2, U3.22 (~FAULT); also elsewhere on the board
DRV_NSCS: U3.36 (~SCS); also elsewhere on the board
DRV_NSLEEP: R13.1, U3.23 (~SLEEP); also elsewhere on the board
DRV_SCLK: U3.35 (SCLK); also elsewhere on the board
DRV_SDI: U3.34 (SDI); also elsewhere on the board
DRV_SDO: R12.2, U3.33 (SDO); also elsewhere on the board
GND: C20.2, C21.2, C22.2, C23.2, C26.2, C27.2, C28.2, R13.2, U3.2 (AGND), U3.4 (GND_BK), U3.12 (PGND), U3.15 (PGND), U3.18 (PGND), U3.26 (AGND), U3.41 (PAD); also elsewhere on the board
INHA: U3.27 (INHA); also elsewhere on the board
INHB: U3.29 (INHB); also elsewhere on the board
INHC: U3.31 (INHC); also elsewhere on the board
INLA: U3.28 (INLA); also elsewhere on the board
INLB: U3.30 (INLB); also elsewhere on the board
INLC: U3.32 (INLC); also elsewhere on the board
PHASE_A: U3.13 (OUTA), U3.14 (OUTA); also elsewhere on the board
PHASE_B: U3.16 (OUTB), U3.17 (OUTB); also elsewhere on the board
PHASE_C: U3.19 (OUTC), U3.20 (OUTC); also elsewhere on the board
SOA: U3.40 (SOA); also elsewhere on the board
SOB: U3.39 (SOB); also elsewhere on the board
SOC: U3.38 (SOC); also elsewhere on the board

Notes on the sheet:
DRV8316CR notes (datasheet SLVSH07): - Internal buck is unused but its pins may not float (8.3.4): resistor mode, R10 22R + C26. Firmware: set BUCK_CL=1 or BUCK_DIS=1 over SPI. - VREF tied to AVDD (3.3 V): SOx = VREF/2 +/- GAIN x I. Set GAIN over SPI (1.2 V/A suits a gimbal motor). - nFAULT pulled 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

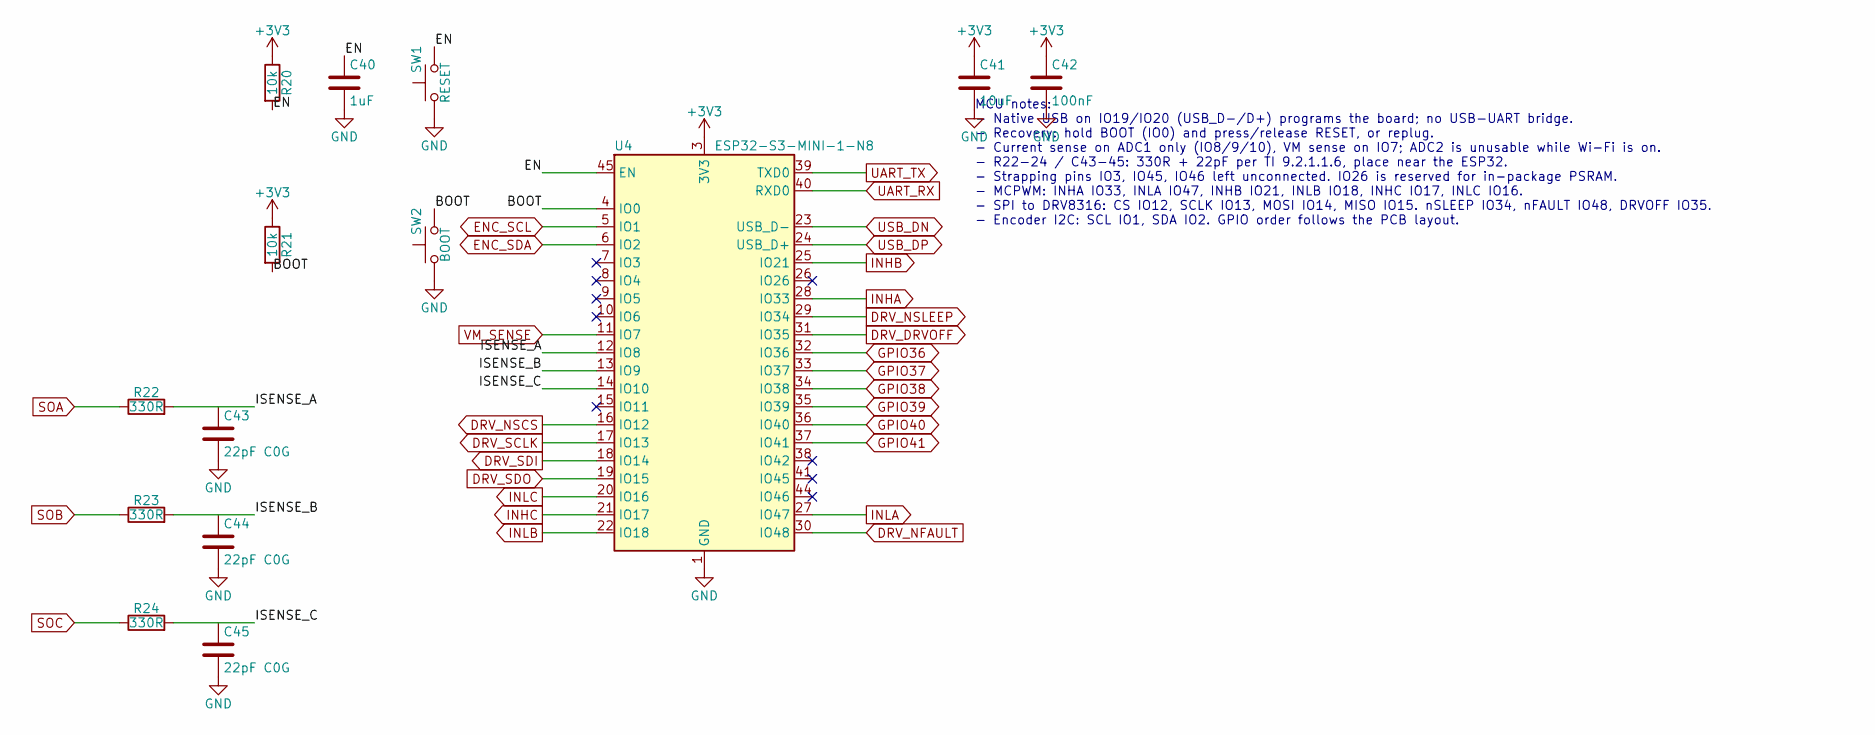
[picture p29: schematic mcu.kicad_sch]

Parts:
C40: 1uF; C_0402_1005Metric; LCSC C52923
C41: 10uF; C_0603_1608Metric; LCSC C19702
C42: 100nF; C_0402_1005Metric; LCSC C1525
C43, C44, C45: 22pF C0G; C_0402_1005Metric; LCSC C1555
R20, R21: 10k; R_0402_1005Metric; LCSC C25744
R22, R23, R24: 330R; R_0402_1005Metric; LCSC C25104
SW1: RESET; SW_Push_1P1T_XKB_TS-1187A; LCSC C318884
SW2: BOOT; SW_Push_1P1T_XKB_TS-1187A; LCSC C318884
U4: ESP32-S3-MINI-1-N8; ESP32-S2-MINI-1; LCSC C2913206

Connections:
+3V3: C41.1, C42.1, R20.1, R21.1, U4.3 (3V3); also elsewhere on the board
/MCU/BOOT: R21.2, SW2.2, U4.4 (IO0)
/MCU/EN: C40.1, R20.2, SW1.2, U4.45 (EN)
/MCU/ISENSE_A: C43.1, R22.2, U4.12 (IO8)
/MCU/ISENSE_B: C44.1, R23.2, U4.13 (IO9)
/MCU/ISENSE_C: C45.1, R24.2, U4.14 (IO10)
DRV_DRVOFF: U4.31 (IO35); also elsewhere on the board
DRV_NFAULT: U4.30 (IO48); also elsewhere on the board
DRV_NSCS: U4.16 (IO12); also elsewhere on the board
DRV_NSLEEP: U4.29 (IO34); also elsewhere on the board
DRV_SCLK: U4.17 (IO13); also elsewhere on the board
DRV_SDI: U4.18 (IO14); also elsewhere on the board
DRV_SDO: U4.19 (IO15); also elsewhere on the board
ENC_SCL: U4.5 (IO1); also elsewhere on the board
ENC_SDA: U4.6 (IO2); also elsewhere on the board
GND: C40.2, C41.2, C42.2, C43.2, C44.2, C45.2, SW1.1, SW2.1, U4.1 (GND), U4.2 (GND), U4.42 (GND), U4.43 (GND), U4.46 (GND), U4.47 (GND), U4.48 (GND), U4.49 (GND), U4.50 (GND), U4.51 (GND), U4.52 (GND), U4.53 (GND), U4.54 (GND), U4.55 (GND), U4.56 (GND), U4.57 (GND), U4.58 (GND), U4.59 (GND), U4.60 (GND), U4.61 (GND), U4.62 (GND), U4.63 (GND), U4.64 (GND), U4.65 (GND); also elsewhere on the board
GPIO36: U4.32 (IO36); also elsewhere on the board
GPIO37: U4.33 (IO37); also elsewhere on the board
GPIO38: U4.34 (IO38); also elsewhere on the board
GPIO39: U4.35 (IO39); also elsewhere on the board
GPIO40: U4.36 (IO40); also elsewhere on the board
GPIO41: U4.37 (IO41); also elsewhere on the board
INHA: U4.28 (IO33); also elsewhere on the board
INHB: U4.25 (IO21); also elsewhere on the board
INHC: U4.21 (IO17); also elsewhere on the board
INLA: U4.27 (IO47); also elsewhere on the board
INLB: U4.22 (IO18); also elsewhere on the board
INLC: U4.20 (IO16); also elsewhere on the board
SOA: R22.1; also elsewhere on the board
SOB: R23.1; also elsewhere on the board
SOC: R24.1; also elsewhere on the board
UART_RX: U4.40 (RXD0); also elsewhere on the board
UART_TX: U4.39 (TXD0); also elsewhere on the board
USB_DN: U4.23 (USB_D-); also elsewhere on the board
USB_DP: U4.24 (USB_D+); also elsewhere on the board
VM_SENSE: U4.11 (IO7); also elsewhere on the board

Notes on the sheet:
MCU notes: - Native USB on IO19/IO20 (USB_D-/D+) programs the board; no USB-UART bridge. - Recovery: hold BOOT (IO0) and press/release RESET, or replug. - Current sense on ADC1 only (IO8/9/10), VM sense on IO7; ADC2 is unusable while Wi-Fi is on. - R22-24 / C43-45: 330R + 22pF per TI 9.2.1.1.6, pla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

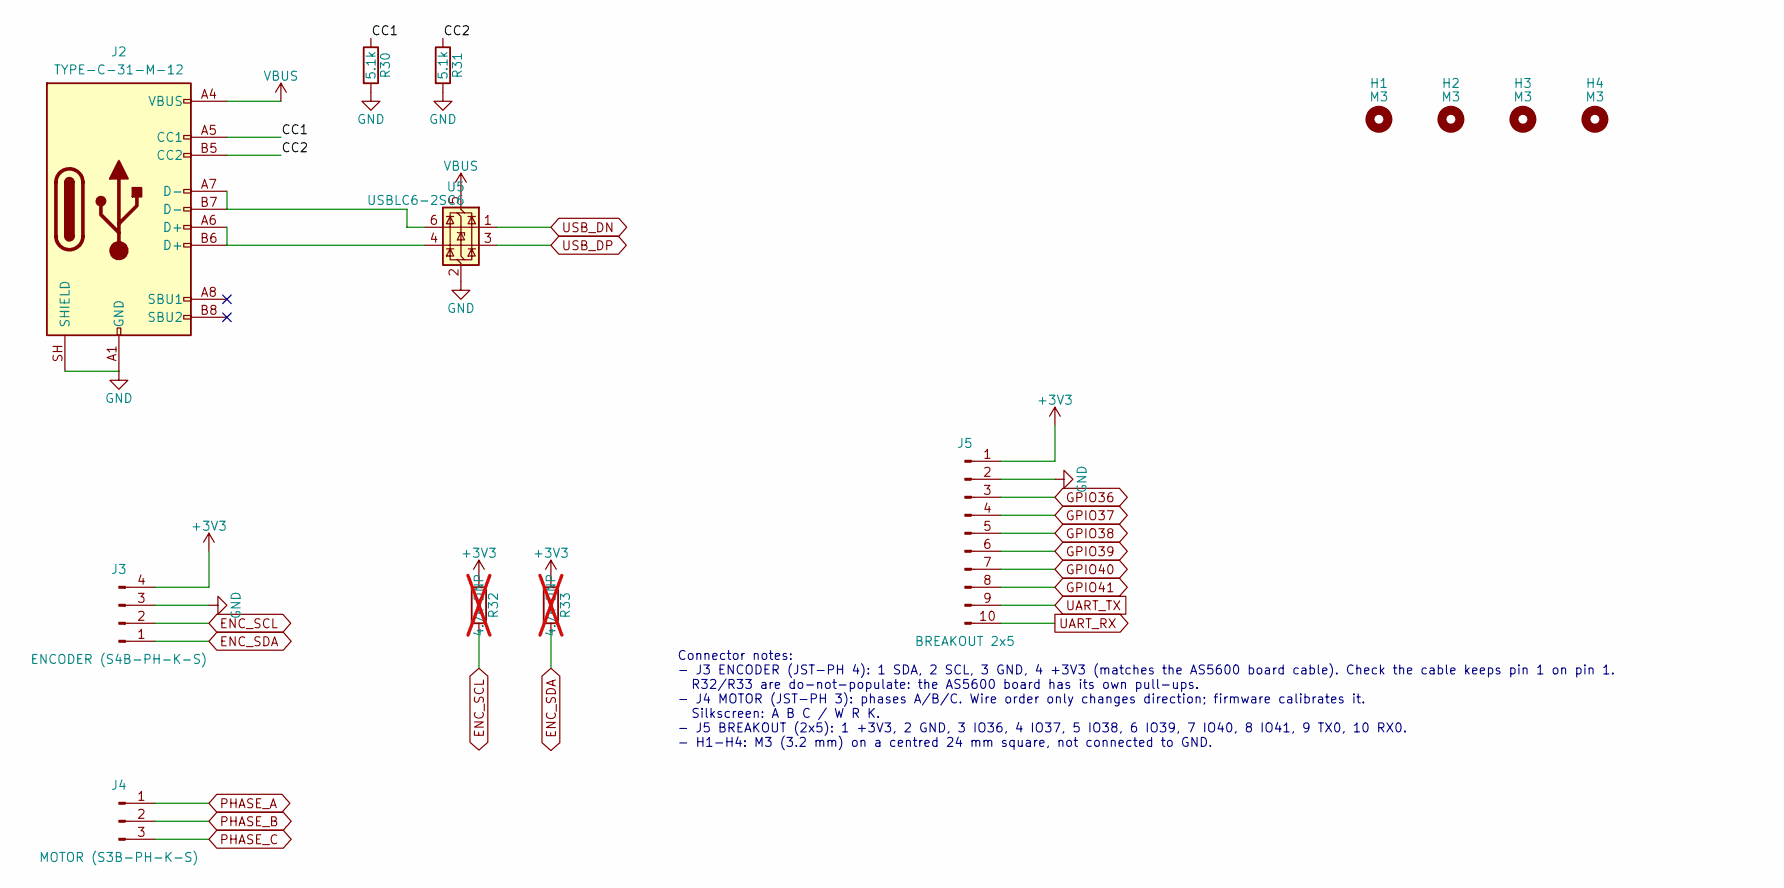
[picture p30: schematic connectors.kicad_sch]

Parts:
H1, H2, H3, H4: M3; MountingHole_3.2mm_M3
J2: TYPE-C-31-M-12; USB_C_Receptacle_HRO_TYPE-C-31-M-12; LCSC C165948
J3: ENCODER (S4B-PH-K-S); JST_PH_S4B-PH-K_1x04_P2.00mm_Horizontal; LCSC C157926
J4: MOTOR (S3B-PH-K-S); JST_PH_S3B-PH-K_1x03_P2.00mm_Horizontal; LCSC C157929
J5: BREAKOUT 2x5; PinHeader_2x05_P2.54mm_Vertical
R30, R31: 5.1k; R_0402_1005Metric; LCSC C25905
R32, R33: 4.7k DNP; R_0402_1005Metric; LCSC C25900; not fitted
U5: USBLC6-2SC6; SOT-23-6; LCSC C7519

Connections:
+3V3: J3.4, J5.1, R32.1, R33.1; also elsewhere on the board
/Connectors/CC1: J2.A5 (CC1), R30.1
/Connectors/CC2: J2.B5 (CC2), R31.1
ENC_SCL: J3.2, R32.2; also elsewhere on the board
ENC_SDA: J3.1, R33.2; also elsewhere on the board
GND: J2.A1 (GND), J2.A12 (GND), J2.B1 (GND), J2.B12 (GND), J2.SH (SHIELD), J3.3, J5.2, R30.2, R31.2, U5.2 (GND); also elsewhere on the board
GPIO36: J5.3; also elsewhere on the board
GPIO37: J5.4; also elsewhere on the board
GPIO38: J5.5; also elsewhere on the board
GPIO39: J5.6; also elsewhere on the board
GPIO40: J5.7; also elsewhere on the board
GPIO41: J5.8; also elsewhere on the board
unnamed: J2.A6 (D+), J2.B6 (D+), U5.4 (I/O2)
unnamed: J2.A7 (D-), J2.B7 (D-), U5.6 (I/O1)
PHASE_A: J4.1; also elsewhere on the board
PHASE_B: J4.2; also elsewhere on the board
PHASE_C: J4.3; also elsewhere on the board
UART_RX: J5.10; also elsewhere on the board
UART_TX: J5.9; also elsewhere on the board
USB_DN: U5.1 (I/O1); also elsewhere on the board
USB_DP: U5.3 (I/O2); also elsewhere on the board
VBUS: J2.A4 (VBUS), J2.A9 (VBUS), J2.B4 (VBUS), J2.B9 (VBUS), U5.5 (VBUS); also elsewhere on the board

Notes on the sheet:
Connector notes: - J3 ENCODER (JST-PH 4): 1 SDA, 2 SCL, 3 GND, 4 +3V3 (matches the AS5600 board cable). Check the cable keeps pin 1 on pin 1. R32/R33 are do-not-populate: the AS5600 board has its own pull-ups. - J4 MOTOR (JST-PH 3): phases A/B/C. Wire order only changes direction; firmware calibrat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

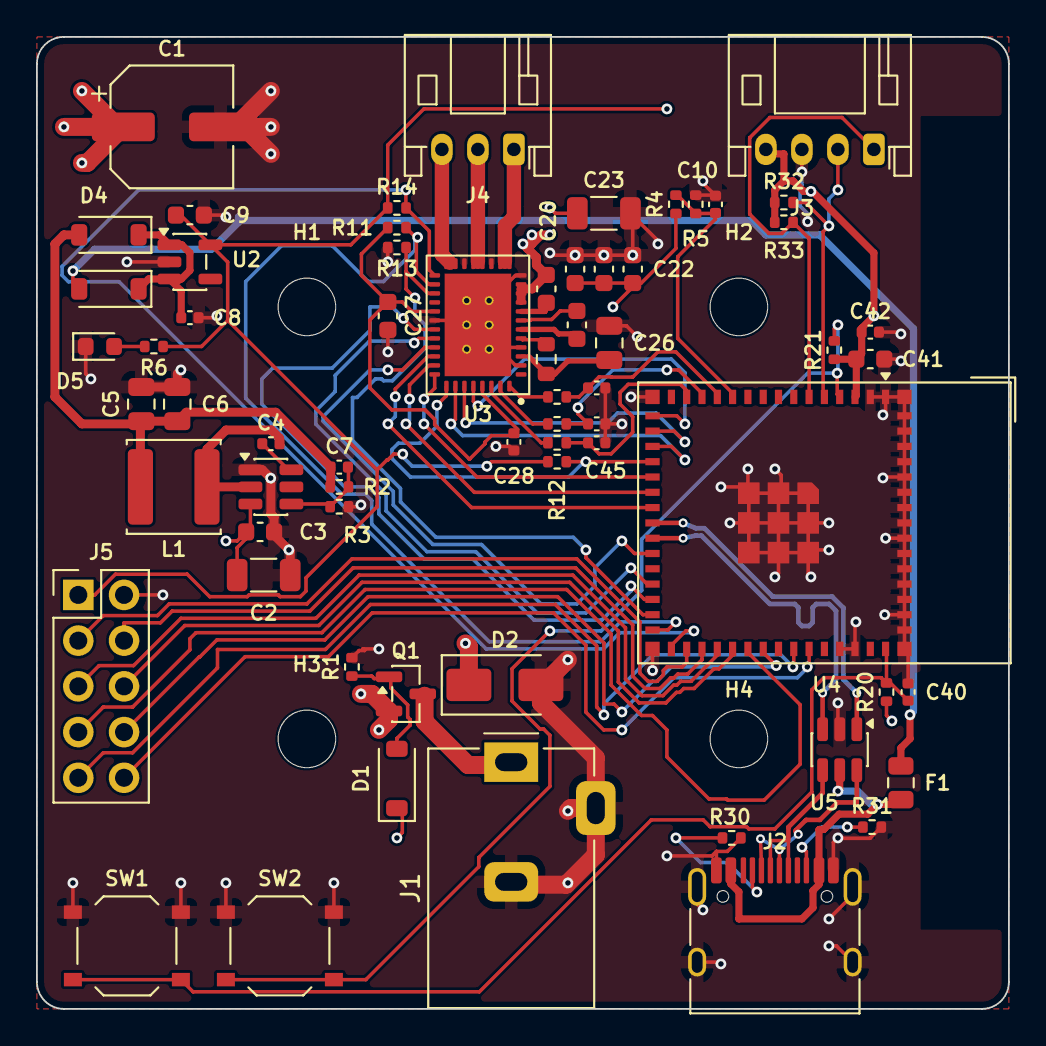
[picture p31: board smartknob_driver.kicad_pcb from above]

Board: 4 copper layers, 54.0 x 54.0 mm, 69 parts (0 on the bottom side), 60 nets.
